jphacks/fk_2603/FEATURES.md

# 二度寝防止アラーム「ドパドパクラッシャー」機能一覧

コード（ファーム `.ino` と Android の Kotlin）を正として整理したもの。ドキュメントとコードが食い違っている箇所は末尾の「要確認」にまとめた。

## 0. 全体構成

- **M5Stack Basic と FSR406（圧力センサ）**: ベッド（枕）の下に置き、在床判定・アラームの鳴動・起床判定・二度寝判定・睡眠記録を**すべて M5Stack 側**で行う
- **Android アプリ**（Kotlin / Jetpack Compose）: アラームの設定、スマホのロック、記録・戦績の表示
- 通信は **BLE のみ**（Wi-Fi・インターネットは使わない。INTERNET 権限もなし）。時刻はスマホから M5Stack に送る
- 記録はすべて端末内の CSV。他人との共有やランキングはない

## 1. M5Stack（ファーム）

### 在床判定

- 圧力の raw 値（0〜4095）を8回平均し、**しきい値300以上でベッドにいる**と判定する
- しきい値付近で判定が揺れないよう、50 のヒステリシスを持たせている
- しきい値（100〜3500）はアプリから変更でき、NVS に保存されるので電源を切っても残る

### アラームの状態遷移

| 状態 | 動作 |
|---|---|
| IDLE → ARMED | アプリからアラームがセットされる |
| ARMED → RINGING | アラーム時刻にベッドにいれば鳴る |
| ARMED → WAITING | アラーム時刻にベッドにいなければ鳴らさずに待つ。10分以内にベッドに入ったら鳴る。10分過ぎたらそのアラームは終わり |
| RINGING | ベッドにいる間だけ音が鳴る（2kHz、0.5秒周期）。ベッドを出た瞬間に止まり、戻るとまた鳴る。鳴る時間に上限はない |
| RINGING → AWAKE | ベッドを出て**10秒**たつと起床と判定して記録する（5〜300秒でアプリから変更可）。ベッドの外で C ボタン、またはアプリの「止める」を押すと即起床 |
| AWAKE → RESLEEP_ARMED | 起床から**20分以内**にベッドへ戻り、そのまま60秒たつと二度寝と判定する |
| RESLEEP_ARMED → RINGING | ベッドに**戻った時刻から5分後**に再アラーム。鳴る前にベッドを出れば取り消す |
| AWAKE → IDLE/ARMED | 起床から20分たつと監視を終える |

- 起床記録の中身は、鳴った時刻・ベッドを出た時刻・離床までの秒数・二度寝フラグ
- **スマホのロック条件 = ベッドにいる、または RINGING / RESLEEP_ARMED**

### 睡眠記録（アラームとは関係なく取る）

- 20分続けてベッドにいたら睡眠開始とみなす。開始時刻はベッドに入った時刻までさかのぼる
- 10秒未満の途切れはセンサーの誤差として無視する
- 20分以上ベッドを離れたら睡眠を確定する。起床時刻は最後にベッドを出た時刻
- 就寝（S）・二度寝（R）・起床（E）のイベントをアプリに送る。アプリが受け取るまで RAM に16件までためておく

### ボタン

- **A**: 音量アップ。5秒長押しで登録したスマホをすべて消す（ベッドの外にいるときだけ）
- **B**: 音量ダウン（1〜10段階。起動時は1で、ミュートにはならない）
- **C**: 鳴動中に押すと起床を確定する（ベッドの外にいるときだけ）。3秒長押しで QR を120秒表示し、スマホを追加登録できる（ベッドの外にいて、アラーム処理中でないときだけ）

### LCD の表示

時刻、状態、LOCK、アラーム時刻、FSR の値と在床、前回の離床秒数、睡眠時間、BLE の状態（waiting / connected / SECURE）、登録スマホ数、BLOCKED 回数、音量を表示する。

### 時刻

- RTC がないので、電源を入れ直すとスマホとつながるまで `time not set` になり、アラームもセットできない
- スマホから接続時と4分ごとに時刻を受け取る
- 鳴動中・WAITING 中・アラーム時刻の前後60秒は、届いた時刻を反映しない

### セキュリティ

- 初回起動時に P-256 の鍵を作る。登録が1台もなければ起動時から QR を表示する
- QR を読んだスマホとだけ ECDH で鍵を共有し、以降の通信はすべて AES-256-GCM で暗号化する（登録は最大4台）
- 平文や認証前の命令は捨て、`BLOCKED` 回数を増やす。カウンタでリプレイも防ぐ
- 広告名は `WakeUp-<devId>`

## 2. Android アプリ

### 常駐サービス（MonitorService）

- フォアグラウンドサービスとして M5Stack と BLE でつながり続け、1秒ごとに状態を受け取る。端末を再起動しても再開する
- **アラーム中**: どのアプリの上にも全画面のアラーム画面を出す
- **ベッドにいる間**: 登録したアプリを前面に出したときだけロック画面を出す（0.3秒ごとに確認）
  - 「使用状況へのアクセス」が未許可のときは、スマホ全体をロックする
- **ベッドを出て3秒**で、M5Stack の起床判定を待たずにロックを外す。ベッドに戻ればすぐロックする
- 画面ロックを解除した瞬間にも、ロックするかを判定し直す
- M5Stack と切れたままアラーム時刻を過ぎたら、鳴っているとみなしてロックする
- M5Stack と5分通信できなければロックを外す（電源が切れて永久にロックされるのを防ぐ）
- 起床記録が届くと、アプリを開いていなくてもクリア画面を出す
- ホームのアラームのうち、**一番近い1件を自動で M5Stack に送る**。M5Stack が IDLE / ARMED / AWAKE のときだけ送り、失敗したら10秒おきに送り直す
- 起床・睡眠・圧力・スマホ利用時間を CSV に保存する。利用時間は1時間ごとに保存する

### ホーム

- あいさつ、レベル、XP
- 未登録なら「デバイスを追加」を出し、Google Code Scanner で QR を読む（カメラの権限は不要）
- 権限が足りないと警告を出す（重ねて表示 / 電池の最適化 / 使用状況へのアクセス）
- **NEXT MISSION**: 次のアラームの時刻、今日か明日か、残り時間
- **MORNING ROUTINE**: タスクのチェックリスト。対象は次のアラームの日（18時以降なら翌日分）。「完了数 / タスク数」も出す
- 制限アプリ数、監視キャラ（在床で台詞が変わる）、ベッドセンサーの状態、連続起床日数
- **ALARMS**: 複数登録でき、曜日の指定もできる（指定しなければ1回だけ）。オン/オフと削除ができ、1回だけのアラームは鳴ったら自動でオフになる。鳴動中は変更できない
- 「アラームを鳴らす」デモ（下記）
- 「DEBUG: 10秒後にアラーム」ボタン

### アラーム画面

- 現在時刻と「二度寝」表示
- **スヌーズボタン**: 押しても止まらず、「スヌーズ？ないよ。」などの台詞が出るだけ
- ベッドを出ていると「アラームを止める」ボタンが出る。押さなくても「あと◯秒で自動停止」と表示し、時間がたてば止まる
- 緊急解除ボタン

### ロック画面

- ベッドにいる時間、圧力ゲージ（しきい値の目盛りつき）、封印中のアプリのアイコン
- 「ホームに戻る」で抜けられる。登録していないアプリと緊急通話は使える
- 緊急解除ボタン

### 緊急解除

- 2回押すと（1回目から5秒以内）5分間ロックを外す
  - 登録アプリのロック画面から使うと、そのアプリだけを解除する
  - スマホ全体のロック中なら全体を解除する
- アラームは止まらない
- 1回目を押すと「◯日の連続記録が0に戻ります」と警告する
- 回数・アプリ別の回数・「緊急解除しなかった日」の連続日数を記録する（1日の区切りは朝4時）

### クリア画面（起床後）

- MISSION CLEAR、ランク、離床タイム、連続起床日数、獲得 XP、XP バー、レベルアップ、新しい称号
- 就寝・アラーム・起床の時刻と睡眠時間、総評（起き方と睡眠時間についてひとことずつ）
- 今日のルーティンを「今日の予定」として表示する
- 「スマホを解放する」で閉じる

### 戦績

- プレイヤーカード（称号、レベル、直近7回の平均ランク、7日間の勝敗、連続日数、最速記録）
- 7日間のグラフ（離床までの時間。5分以内に出れば WIN、二度寝か遅ければ LOSE）
- 称号ステッカー6種（うち1つは隠し）
- 朝タスクの記録（日ごとの完了数 / タスク数、0〜10点、直近7日の平均）
- 「スマホ使用データ」画面: 権限、Android に残っている記録の量、導入前の1日平均、端末に貯めた日数、緊急解除の回数、日ごとの合計

### ゲーム要素（起床記録から毎回計算する）

- ランクと XP: S は60秒以内で150XP、A は3分以内で110、B は7分以内で70、C はそれより遅く30。二度寝は0XP
- 100XP で1レベル上がる
- 連続起床 = WIN の日が続いている日数

### デバイス画面

- 接続状態、状態、音量、最後に同期してからの時間、暗号化の表示（ID）
- 圧力ログのグラフ（直近8時間、1分平均）。就寝と離床の目印つき
- 判定の調整: 在床しきい値、離床確認時間。M5Stack に保存され、ベッドにいる間とアラーム中は変更できない
- ロックするアプリの選択（検索、すべて登録、すべて外す。最初は何も登録されていない）
- 緊急解除の統計（合計 / 7日間 / しなかった連続日数 / アプリ別の回数）
- ニックネーム
- 睡眠ログ（就寝 → 起床）
- 自分の記録をすべて削除（起床・睡眠・ルーティン）
- M5Stack の登録解除。M5Stack 側で QR を出す（`p:1`）と、スマホ側も自動で登録を解除する

### デモと初回データ

- ホームのデモでは、アラーム → ロック → 「ベッドから出る」シミュレーション → クリア画面までをアプリ内だけで流す。記録には残らない
  - ただし、デモ中の緊急解除は本物として数えられる
- 初回起動時に、1週間分のデモ記録（起床・睡眠・ルーティン）を本番と同じ保存処理で取り込む

### 保存先

- CSV: `wake_records` / `sleep_records` / `pressure_log` / `emergency_log` / `routine_log` / `screen_time_daily` / `screen_time_baseline`
- 設定（アラーム、ルーティンの定義、ロックするアプリ、ニックネームなど）は SharedPreferences

## 要確認（ドキュメントとコードの食い違い・気になる点）

1. **二度寝と判定する時間**: README の上の方に「起床後10分以内」と書いた箇所があるが、コードは**20分**
2. **ランキングと Firebase**: ルートの README には「ランキングで競える / Firebase」と書いてあるが、コードにはどちらもない。デバイス画面にも「ランキングに出る名前」「ランキングの記録を削除」という文言が残っている
3. **ホームのデモボタン**: HANDOFF には「外した」とあるが、コードでは**表示されている**。「DEBUG: 10秒後にアラーム」ボタンも常に表示されている（本番でも出したままでよいか）
4. **連続記録が2種類ある**: ホーム・戦績の「連続起床」（WIN が続いた日数）と、ロック画面・デバイス画面の「緊急解除しなかった連続日数」は別物
5. **C ボタン長押しの意味**: README は「再接続モード」と呼んでいる。実装では「スマホの追加登録（QR 表示）」で、同時に既に登録してあるスマホ側の登録も解除される
6. `arduino/wakeup_alarm/config.h` に **Wi-Fi の SSID とパスワードが平文で書いてある**。ファームでは使っていない（別プロジェクトの残りに見える）。公開リポジトリに置くなら削除を推奨
