jphacks/fk_2603/(commit log)

2026-10-24 二度寝防止アラーム（M5Stack + FSR406 + Android）を追加
    - M5Stack: 圧力センサでベッドの在/不在を判定し、ベッドにいる間だけアラームを鳴らす
    - アラーム時刻にベッドにいなければ10分以内に入ったときに鳴らす
    - 起床後10分以内に戻ったら5分後に再アラーム
    - スマホとは BLE で通信し、時刻もスマホから受け取る
    - Android: ベッドにいる間とアラーム中はスマホを全画面ロック
    - Firebase（匿名認証 + Firestore）で起床までの時間をランキング
    - google-services.json と config.h は git 管理外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
2026-10-24 睡眠記録（就寝・起床・二度寝）を追加
    - M5Stack: ベッドに20分続けていたら就寝（10秒未満の途切れはセンサー誤差として無視、開始時刻は入った瞬間）、
    20分以内の離床は継続、20分離れたら起床（最後にベッドを出た時刻）
    - アラーム後にベッドへ戻ったら二度寝として記録。記録中の睡眠がなければ戻った時刻から開始
    - 二度寝監視の時間を10分から20分に変更
    - 就寝 S / 二度寝 R / 起床 E のイベントを状態 JSON の e で送り、アプリの evack で次へ進む（最大16件保持）
    - アプリ: イベントから睡眠記録を組み立て、CSV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
2026-10-25 ドパドパクラッシャーの UI を Jetpack Compose に移植し、バックとつなぐ
    - AppUI ブランチの Next.js プロトタイプを Compose で再実装（ホーム / 戦績 / デバイス / クリア / アラーム・ロック画面）
    - ロック中のオーバーレイを Compose 化し、アラーム中は全体ロック、在床中は封印カテゴリのアプリだけロック（使用状況アクセス）
    - XP・レベル・連続起床・バッジ・週グラフを記録から計算、圧力ログ（直近8時間）を保存
    - M5Stack に config コマンドを追加し、在床しきい値・離床確認時間をアプリから変更・NVS に保存
    - AGP 9.4.1 / Ko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
2026-10-25 CSV 記録・複数アラーム・ルーティン・QR ペアリングと BLE 暗号化を追加
    - 記録をすべて端末の CSV に（Firebase / AWS 共有は削除、INTERNET 権限も削除）
    - ホームはチーム版（1d4e2d8）の複数アラーム・MORNING ROUTINE をバックにつないで移植
    - 一番近いアラームをサービスが M5Stack に自動送信、離床3秒でロック解除
    - 緊急解除・連続記録・スマホ利用時間の比較、1週間分のデモデータ
    - QR ペアリングと BLE 暗号化（SecureChannel / PairingStore / secure_link）
2026-10-25 登録したアプリだけをロックし、開いたときにロック画面を出す
    - ロックの対象を「全アプリから外す」方式から「登録したアプリだけ」に変更（最初は空）
    - アラーム中もベッドにいる間も、登録アプリが前面に来たときだけ全画面のロック画面を出す
    - アラーム画面にも「ホームに戻る」を追加
    - 前面アプリの確認を 1 秒から 0.3 秒ごとにして、開いてすぐ出るように
    - 使用状況へのアクセスが未許可のときは従来どおり全体をロック
2026-10-25 OKI:LOCK のロゴ・アイコンと接続成功ポップアップを追加
    - ホームのヘッダーを OKI:LOCK のロゴ画像に置き換え（挨拶文は削除）
    - ランチャーアイコンを OKI:LOCK のキャラに変更
    - M5 がつながったら「接続成功」を 2 秒だけ表示
    - 就寝中のスマホ使用ログ、起床フィードバックなど作業中の変更を含む
